lawsonkeith/MVPTest/label2.pptx

VALVE PACK PCB TESTER

1. Plug in J1-9 of MVP:
2. Press the green test button
3. Board jumper configuration and revision will be auto detected
4. LED status RED=FAIL, GREEN=PASS
5. Connect USB connector to terminal to get report
6. Set up as 115200 Baud 8,N,1 / ANSI emulation / FTDI driver

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
Instructions

0V

MFVP

Test

Status

24V

Instructions

VALVE PACK PCB TESTER

1. Plug in J1-9 of MVP:
2. Press the green test button
3. Board jumper configuration and revision will be auto detected
4. LED status RED=FAIL, GREEN=PASS
5. Connect USB connector to terminal to get report
6. Set up as 115200 Baud 8,N,1 / ANSI emulation / FTDI driver

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
MFVP

Test

Status
