lawsonkeith/MVPTest/(commit log)

2016-05-06 Update MVPComms.ino
    Fixes sensor array size
    [MVPComms.ino]
2016-05-06 Update MVPComms.ino
    Moist / temp sensor data fix
    [MVPComms.ino]
2016-05-06 mist memory bug fixes
    [MVPComms.ino]
2016-05-18 Board working with MVP
2016-06-08 Initial working version
    Needs legacy PCB state adding in.
2016-06-08 Added lo-res board, finalised test parameters
2016-06-15 More bug fixes to fix intermittent fails
    [MVPComms.ino]
2016-06-16 Added 2nd Label for 2nd prototype
2016-06-21 Second prototype
    Recalibration
    Voltage compensation
    Skip next test 'n' feature
    [MVPComms.ino]
2016-08-25 Added support for 2nd lo-res board type
